YukkuriPannda/vibe_comp/kicad/bass_compressor/render/bass_compressor_render.png

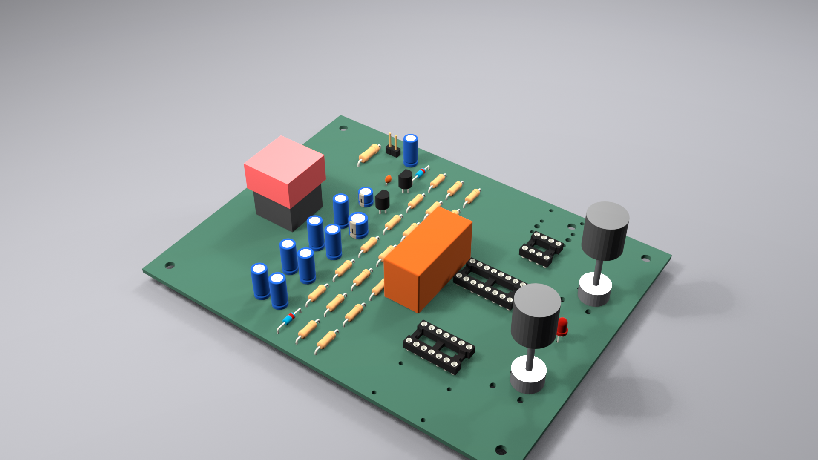
kicad/bass_compressor/render/bass_compressor_render.png
