YukkuriPannda/vibe_comp/docs/circuit_reference.md

# 回路設計（Phase 1 確定版 / 2026-07-01）

**重要**: この回路はデータシートの式・KiCad標準シンボルのピン配置と照合して設計したオリジナル設計であり、既存の特定ペダル(Ross Compressor等)のコピーではない。**まだSPICEシミュレーション(Phase2)・ブレッドボード試作(Phase3)による実機検証を行っていない。** 基板発注(Phase6)の前に必ずPhase2/3を実施すること。特にコンプレッサーは帰還の極性を間違えると圧縮ではなく発振・エキスパンダー的動作になるため、試作確認は必須。

## 使用ICのピン配置（データシート/KiCad標準シンボルで確認済み）

### LM13700（16pin DIP, デュアルOTA）— TIデータシート(SNOSBW2F)の "Pin Functions" 表で確認
| Pin | 機能 | Pin | 機能 |
|---|---|---|---|
| 1 | IABC1（ゲイン制御電流入力） | 9 | Buffer Output 2 |
| 2 | Diode Bias 1 | 10 | Buffer Input 2 |
| 3 | Non-inverting Input 1 (+) | 11 | V+ |
| 4 | Inverting Input 1 (−) | 12 | Output 2 |
| 5 | Output 1 | 13 | Inverting Input 2 (−) |
| 6 | V− | 14 | Non-inverting Input 2 (+) |
| 7 | Buffer Input 1 | 15 | Diode Bias 2 |
| 8 | Buffer Output 1 | 16 | IABC2 |

今回は**OTA#1（pin1-8）のみ使用**、OTA#2は未使用（後述の通り無効化）。

### TL072（8pin DIP, デュアルオペアンプ）— 標準ピン配置
1=Out1, 2=In1(−), 3=In1(+), 4=V−, 5=In2(+), 6=In2(−), 7=Out2, 8=V+

### TC4013BP（14pin DIP, デュアルDフリップフロップ）— 標準ピン配置
1=Q1, 2=/Q1, 3=CLK1, 4=RESET1, 5=D1, 6=SET1, 7=VSS(GND), 8=SET2, 9=D2, 10=RESET2, 11=CLK2, 12=/Q2, 13=Q2, 14=VDD

今回は**フリップフロップ#1のみ使用**（トグル動作: /Q1をD1に帰還）。

## 全体ブロック構成

```
入力Jack(J1,電池ON/OFF兼用)
  → 入力バッファ(U1A)
  → OTAゲイン制御段(IC1 LM13700 OTA#1、Sustainで帰還量を調整)
  → メイクアップゲイン段(U1B)
  → Levelポット(VR2)
  → 出力Jack(J2)

OTA出力ノード → エンベロープ検出(D1,C_hold等) → Sustainポット(VR1) → Q_ctrl(NPN) → IABC1(帰還でゲイン低下=圧縮)

Cherry MXスイッチ(SW1、手持ち部品) → デバウンス → TC4013 Dフリップフロップ(トグル)
  → Q_relay(NPN)駆動 → リレー(RL1, DPDT) → 信号経路をトゥルーバイパス切替
  → LED1(フリップフロップの状態を表示)
```

## 1. 電源・バイアス

| 部品 | 値 | 備考 |
|---|---|---|
| BT1 | 9V電池 | J1のスイッチ接点経由でON/OFF |
| C_pwr1 | 100µF/16V 電解 | V+-GND間、電源デカップリング |
| C_pwr2 | 0.1µF セラミック | 同上、高周波用 |
| R1, R2 | 100kΩ ×2 | V+-GND分圧、中点=Vref(≈4.5V)。オペアンプ段のバイアス基準専用（LM13700本体のV−ピンは真のGND=0Vに接続、Vrefには繋がない） |
| C_vref | 10µF 電解 | Vrefノード-GND、バイアス安定化 |

## 2. 入力バッファ（U1A: TL072 1回路目）

| 部品 | 値 | 備考 |
|---|---|---|
| C_in | 0.1µF フィルム | 入力DCブロック |
| R_inbias | 1MΩ | C_in後段からVrefへ。入力インピーダンス≈1MΩ、C_inとのカットオフ≈1.6Hz（4弦ベース最低音41Hzを一切減衰させない） |
| U1A | TL072 pin3(+)=上記ノード, pin2(−)=pin1(出力)に直結（ボルテージフォロワ）, pin4=GND, pin8=V+ |

## 3. OTAゲイン制御段（IC1: LM13700 OTA#1）

**【2026-07-01 SPICE検証で追加修正】** LTspice + LM13700の実トランジスタレベルSPICEモデル(deanm1278/LM13700-spice-model, TIの公開回路を元にしたもの)で検証した結果、以下2点の設計不備が判明し修正した:

1. **入力にアッテネータが必要だった**: U1Aの出力(最大1.6Vpp程度を想定)をそのままOTAの差動入力に入れると、OTAの実用線形入力範囲(データシートFig.20の例で「1Vpの入力を33mVppまで減衰させる」と明記、リニアライズダイオード使用時でも60mVpp程度が上限)を100倍以上超えてしまい、圧縮が効く前にほぼ常時ハードクリップする計算になった。→ **U1A出力とOTA入力の間にアッテネータ(1/60程度)を追加**
2. **OTA差動入力のDCバイアス基準点が誤っていた**: 「pin3→GND直結」「pin4→GND直結」という当初設計は、SPICEモデル上で出力が全く出ない(ゲインほぼゼロ)結果になった。差動入力トランジスタがV−レール付近で電流不足になり事実上遮断されるため。→ **pin3・pin4とも基準をGNDではなくVref(4.5V、オペアンプ段と同じ仮想グラウンド)に変更**

これらはSPICEモデル特有の癖ではなく、実チップの差動入力段がV−レール際で正常動作しないという一般的なバイポーラ差動対の制約に起因すると考えられるため、実機でも同様の修正が必要と判断した。

| 部品 | 値 | 接続 | 備考 |
|---|---|---|---|
| R_atten_a | 100kΩ | U1A出力 → ATTMIDノード | 入力アッテネータ上側（Vref基準の減衰、結合コンデンサの**前**に置く。結合コンデンサの後に低い値の抵抗を置くとOTA入力のDCバイアスを壊すことがSPICE検証で判明したため） |
| R_atten_b | 1.6kΩ | ATTMIDノード → Vref | 入力アッテネータ下側。R_atten_a/(R_atten_a+R_atten_b)で約1/63.5に減衰 |
| C2 | 1µF | ATTMIDノード → pin3(Non-inv+) | ACカップリング |
| R3 | 100kΩ | pin3 → **Vref**（2026-07-01修正、旧GND） | 入力DCバイアス基準。GND直結だと出力ゲインがほぼゼロになることをSPICEで確認したため、オペアンプ段と同じVref基準に変更 |
| — | — | pin4(Inv−) → **Vref直結**（2026-07-01修正、旧GND直結） | シングルエンド駆動。理由はpin3と同じ |
| R_D | 7.5kΩ | V+(9V) → pin2(Diode Bias) | ID≈1mA、データシート推奨値でリニアライズ用ダイオード電流を設定（歪み低減。圧縮動作そのものには無関係の固定値） |
| R_ABC | **75kΩ**（2026-07-01再修正、820kΩ→75kΩ） | V+(9V) → pin1(IABC1) | 無音時のベースゲインを設定。IABC≈100µA。SPICEでIABCを20µA〜5mAまで振ったところ、500µA以上では電源電圧(9V)に対してOTA単体のゲインが飽和(クリップ)してしまい、100µA前後が「クリップせず、かつSPICEが素直に収束する」実用的なレンジと判明。OTA単体のゲインは控えめ(入力換算で1〜1.3倍程度)だが、後段の**メイクアップゲイン段(5.7倍)と合わせてトータルで妥当なレベルに戻す**設計とする |
| Q_ctrl | 2SC1815(またはNPN汎用) | コレクタ→pin1、エミッタ→GND、ベース←R_base(2.2kΩ)←VR1ワイパー | エンベロープ電圧に応じてIABCを引き下げ=ゲイン低下=圧縮 |
| RL | 47kΩ | pin5(Output1) → Vref | OTA出力(電流出力)を電圧に変換。gm=19.2×IABC[A] (データシート記載式)、電圧ゲイン=gm×RL |
| pin6(V−) | — | GND直結 | LM13700をV+=9V/V−=0Vのシングル電源で動作 |
| pin11(V+) | — | V+(9V)直結 | 両OTA共通 |
| pin16(IABC2) | — | GND直結 | OTA#2を完全オフ（未使用ユニットの標準処理） |
| pin13,14(OTA2入力) | — | GND直結 | 未使用ユニットのノイズ拾い防止 |
| pin15(Diode Bias2) | — | GND直結 | 同上 |
| pin7,10(Buffer Input 1,2) | — | GND直結 | 未使用バッファの標準処理（出力8,9はNC） |

## 4. エンベロープ検出（Sustain制御ループ）

OTA出力ノード(pin5/RLの接続点)からタップし、圧縮の判定に使う信号を作る。

| 部品 | 値 | 接続 |
|---|---|---|
| C_env | 0.1µF | pin5ノード → ノードA |
| R_envbias | 1MΩ | ノードA → GND（ノードAのDC基準を0Vに設定。AC信号のみ通す） |
| D1 | 1N4148 | アノード=ノードA、カソード→R_attack |
| R_attack | 2.2kΩ | D1カソード → C_hold（アタックタイム τ≈2.2ms） |
| C_hold | 1µF | R_attack後段 → GND（エンベロープ保持コンデンサ） |
| R_release | 220kΩ | C_holdと並列（リリースタイム τ≈220ms） |
| **R_prebias**（2026-07-01追加） | **3.3MΩ** | **V+(9V) → C_hold/R_release側のノード（R_releaseと並列）** | 無信号時のエンベロープノードを約0.56Vにプリバイアスする（下記Phase2検証参照）。R_releaseと並列合成されるため実効リリース抵抗は約206kΩ(τ≈206ms、大きくは変わらない) |
| VR1 (Sustainポット) | 10kΩ（秋月 `RK09D117000B` 等） | C_hold後段(R_prebiasでバイアスされたノード) → ワイパー → R_base(2.2kΩ) → Q_ctrlベース。**電圧分圧のスケーラーとして使用**（直列可変抵抗ではなく、検出電圧がQ_ctrlベースに伝わる比率を調整する構成。秋月で入手できる10kΩ単連ポットでも十分機能するよう設計） |

**Attack/Release値は固定**（前回の仕様確定どおり、ノブはSustain/Levelのみ）。Phase2/3で実際に鳴らしながら微調整可能なようR_attack/R_releaseは基板上でランド互換の値違い品に差し替え可能な配置にしておくと良い。

## Phase 2: 手計算による検証と発見されたバグ（2026-07-01）

SPICEシミュレータ(ngspice/LTspice)がこの環境で即座に使える状態になかったため、データシートの式(gm≈19.2×IABC[A]、VBIAS=2VBE+V−等)を使った手計算での検証を実施。**この過程で実機が正しく動作しない可能性が高い設計バグを2つ発見し、修正した。**

### バグ1: OTA段の無音時ゲインが過大（RL=47kΩ, 旧R_ABC=33kΩ）
- 旧設計: IABC≈233µA → gm=19.2×233µA≈4.48mA/V → 電圧ゲイン=gm×RL=4.48m×47k≈**210倍(46dB)**
- ベース信号(passive想定で0.1〜0.5Vpk程度)を210倍すると21〜105Vppに相当し、9V単電源(Vref=4.5V中心)では物理的に出力し切れず、**圧縮が効く前にほぼ常時ハードクリップする**状態だった
- **対策**: R_ABCを33kΩ→**820kΩ**に変更。IABC≈9.3µA→gm≈179µS→無音時ゲイン≈**8.4倍(18.5dB)**に抑制。0.5Vpk入力でも4.2Vpk程度に収まり、9V電源内で現実的なヘッドルームに収まる

### バグ2: エンベロープ検出電圧がQ_ctrlのベースを駆動できない
- 旧設計: エンベロープノードは無信号時0V基準で、信号が来た時だけD1(1N4148, 順方向降下≈0.6V)経由でC_holdを充電する構成だった。ベース信号は控えめなレベルのことが多く、整流後の電圧(1Vpk入力でも≈0.4V程度)ではQ_ctrl(2SC1815, Vbe(on)≈0.6V)がほとんどオンにならず、**現実的な入力レベルでは圧縮がほぼかからない**可能性が高かった
- **対策**: R_prebias(3.3MΩ, V+→エンベロープノード)を追加し、無信号時のエンベロープノードを約0.56V（Q_ctrlのオン閾値のすぐ下）にプリバイアス。VR1(Sustain)が0の時は結合が切れゲイン変化なし、VR1を上げるほどこのプリバイアス電圧がQ_ctrlベースに伝わり、そこに信号由来の追加電圧が上乗せされることで、小さな信号変化にも敏感に反応するようになる

### 検証はしたが未解決・Phase3実機調整が必要な項目
- [ ] OTA無音時ゲイン8.4倍は概算目標値であり、実際のベース(パッシブ/アクティブ、指弾き/スラップ等)の出力レベルに応じてR_ABC・RLを微調整する必要がある可能性が高い
- [ ] Q_ctrlのVbe(on)や2SC1815の個体差により、R_prebiasの3.3MΩは±20%程度ずれる可能性がある。ブレッドボードでテスターを当てながら微調整すること

## Phase 2b: 実SPICEシミュレーション（LTspice）での検証（2026-07-01）

上記の手計算に続き、実際にLTspiceをインストールし(`winget install AnalogDevices.LTspice`)、LM13700の実トランジスタレベルSPICEモデル（[deanm1278/LM13700-spice-model](https://github.com/deanm1278/LM13700-spice-model)、TIの公開回路がベース）を使って`sim/`ディレクトリでトランジェント解析を行った。

### この検証で追加で見つかり、上記セクション3に反映した設計修正
1. **OTA差動入力へのアッテネータ追加**（1/63.5、R_atten_a/R_atten_b新設）— 手計算では見落としていた、データシート自身が明記する「OTA入力は数十mVppまでしか線形動作しない」という制約に、そのままでは1.6Vpp近い信号を突っ込んでいたことが判明
2. **OTA差動入力(pin3, pin4)の基準をGNDからVrefに変更** — GND直結だとSPICE上でゲインがほぼゼロになることを確認。V−レール際で差動入力トランジスタが実質遮断される
3. **R_ABCを75kΩに再修正**（IABC≈100µA） — SPICEでIABCを20µA〜5mAまで振ったところ、47kΩの負荷抵抗・9V電源の条件では500µA以上でOTA単体のゲインが電源電圧に張り付いて飽和することが分かり、飽和しない範囲に再設定。その分ゲインが控えめになるため、メイクアップゲイン段(5.7倍)と合わせてトータルで帳尻を合わせる設計とした

### 検証の限界（正直に記載）
- 上記1〜3の修正を反映した回路全体でのトランジェント解析（実際に「静かな信号→大きな信号→静かに戻る」を流して波形上で圧縮を確認する）は、**このSPICEモデル特有の収束の癖により最終確認できていない**。具体的には、OTA入力をコンデンサでACカップリングした状態（＝実機と同じ、必須の構成）にすると、SPICEのソルバー（Newton法・Gminステッピング）が物理的に妥当でないと思われる別解に収束してしまう現象が再現性をもって発生し、初期条件の指定(`.ic`/`uic`)やバイアス抵抗値の調整でも解消できなかった
- 一方、OTA単体を理想電圧源で直接駆動した簡易テスト（`sim/isolate_test9.cir`等）では上記の修正方針（Vrefバイアス、適切なIABC範囲）で正常にゲインが出ることを確認済み。**上記1〜3の設計修正自体はデータシートの記述および単体テストの両方と整合しており、妥当性は高いと考えている**
- 結論: **今回のSPICE検証は「新たな2つの設計不備を発見・修正する」という実質的な成果を上げたが、修正後の全体波形での動作確認は未完了。** 最終的な動作確認はPhase3のブレッドボード実測に委ねる
- 関連ファイル: `sim/bass_compressor_test2.cir`（本回路のSPICEネットリスト）、`sim/isolate_test*.cir`（切り分け用の単体テスト群）、`sim/lm13700.sub`（使用したLM13700モデル）

## 5. メイクアップゲイン段（U1B: TL072 2回路目）

| 部品 | 値 | 接続 |
|---|---|---|
| C3 | 1µF | pin5(OTA出力)ノード → U1B pin5(+) |
| R5 | 100kΩ | U1B pin5(+) → Vref |
| R6 | 10kΩ | U1B pin6(−) → GND |
| R7 | 47kΩ | U1B pin6(−) → U1B pin7(出力)（帰還） |
| ゲイン | 1+47k/10k ≈ 5.7倍（≈15dB） | OTA段で失われるレベルを回復 |
| C4 | 1µF | U1B出力 → VR2(Level)へDCブロック |

## 6. 出力段

| 部品 | 値 | 備考 |
|---|---|---|
| VR2 (Levelポット) | 10kΩ Aカーブ（秋月`RK09D117000C`） | C4後段-GND間、ワイパーが出力 |
| C5 | 1µF | VR2ワイパー → J2(出力Jack)、DCブロック |
| J2 | 6.3mm標準ジャック（スイッチなし） | 出力専用 |

出力バッファは設けない（後段の入力インピーダンスが十分高いことを前提とした一般的なパッシブ出力段。TL072は2回路とも上記で使い切っているため追加不可）。

## 7. バイパス回路（Cherry MX + TC4013 + リレー = ソフトタッチ・トゥルーバイパス）

| 部品 | 値 | 接続 |
|---|---|---|
| SW1 | Cherry MX（手持ち） | 一端→GND、他端→ノードB |
| R_pu | 100kΩ | V+ → ノードB（プルアップ） |
| C_db | 0.1µF | ノードB → GND（デバウンス） |
| IC3 (TC4013BP) #1 | — | pin3(CLK1)←ノードB, pin5(D1)←pin2(/Q1)帰還でトグル動作, pin4(RESET1)→GND, pin6(SET1)→GND, pin7(VSS)→GND, pin14(VDD)→V+ |
| R_drive | 10kΩ | pin1(Q1) → Q_relayベース |
| Q_relay | 2SC1815(またはNPN汎用) | ベース←R_drive、コレクタ→リレーコイル(−)、エミッタ→GND |
| D2 (フライバック) | 1N4148 | リレーコイルと並列（カソード→V+側、アノード→コレクタ側）。コイルのスイッチオフ時の逆起電力からQ_relayを保護 |
| **R_coildrop** | **150Ω 1/2W** | **V+(9V) → リレーコイル(+)**。RL1(941H-2C-5D)はコイル定格5V/167Ω/29.9mAだが電源が9Vのため、150Ωを直列に入れてコイル電圧を約4.7Vに制限（データシート実測: 感動電圧4V以上を満たしつつ定格5Vを超えないよう調整） |
| RL1 | 941H-2C-5D（5V DPDT, 秋月） | **【2026-07-01修正】DPDTの2系統とも使い、正しいトゥルーバイパスにする（下記参照）** |
| LED1 + R_led | LED + 2.2kΩ | pin1(Q1) → R_led → LED1アノード、カソード→GND。フリップフロップの状態を直接表示 |

### RL1（DPDT）の正しい配線（修正版）

前バージョンでは「1系統のみ使用、もう1系統は予備」としていたが、これだと未使用側（コンプレッサー回路の出力）が常時出力ジャックに繋がったままになり、バイパス時もコンプレッサー側の出力段が信号経路に乗り続けてしまう（＝本当のトゥルーバイパスになっていない）。DPDTの2系統を両方使い、入力側・出力側を同時に切り替える構成に修正する。

- **Pole 1（入力切替）**: COM=入力信号(J1後段) / NO=C_in（コンプレッサー回路へ） / NC=ノードDRY（バイパス時の直通経路）
- **Pole 2（出力切替）**: COM=出力信号(J2へ) / NO=C5後段（コンプレッサー回路の出力） / NC=ノードDRY（Pole1のNCと同じノード）
- リレー非励磁（バイパス時）: 入力→NC→ノードDRY→NC→出力 の直通経路のみが繋がり、コンプレッサー回路は入力・出力とも完全に切り離される（正しいトゥルーバイパス）
- リレー励磁（エフェクトON時）: 入力→NO→コンプレッサー回路→C5→NO→出力 の経路のみが繋がる

## 8. 未確定・Phase2/3で検証が必要な項目

- [ ] Sustainポットの電圧分圧方式が実際に十分な圧縮レンジを生むか（シミュレーションで確認、R_attack/R_release/R_ABC/RLの微調整が必要になる可能性が高い）
- [ ] R_D(7.5kΩ)によるダイオードバイアス電流とTHDの実測確認
- [ ] リレー用150Ω 1/2W抵抗の発熱・動作電圧マージンの実機確認
- [ ] TC4013のCMOS出力(9V駆動)がLED(2.2kΩ)を直接安定駆動できるか実機確認（理論上は動くが規格上限に近い可能性）
- [ ] IC1(LM13700)は未使用側OTA(pin9-16の一部)も含めて実装時の消費電流を確認（電池駆動のため）
