YukkuriPannda/vibe_comp/bom/部品リスト.md

# 部品リスト（Digikey / Amazon 購入リンク付き）

KiCad回路図から出力したBOM（`kicad/bass_compressor/bom_kicad.csv`）を元に、リファレンス単位ではなく**部品の種類・定数ごとにまとめて集計**したもの。リンクは実在するページを検索・確認済み（2026-07-01〜07-02時点）。価格・在庫はDigikey/Amazon側で変動するため発注直前に必ず確認すること。

**購入リンク・型番・単価の一覧はExcelファイル [`部品リスト.xlsx`](./部品リスト.xlsx) にまとめてある（Digikey/Amazonへのハイパーリンク付き）。このMarkdownファイルは概要・注意点・見積もりのサマリーのみ。**

Cherry MXキースイッチ（SW1）は支給品（手持ち）のため購入対象から除外。

## 部品カテゴリ概要

| カテゴリ | 内容 | 詳細 |
|---|---|---|
| IC/半導体 | IC1 NJM13700D、IC3 TC4013BP(N,F)、U1 TL072CP、D1/D2 1N4148、Q1/Q2 2SC1815 | xlsx参照 |
| リレー・ジャック | RL1 941H-2C-5D、J1（代替品）、J2 Neutrik NMJ4HCD2 | xlsx参照。J1は要注意（後述） |
| ポット | VR1 Alps RK09K1130D62（10kΩB）、VR2 Alps RK09D117000C（10kΩA） | xlsx参照。VR2は要確認（後述） |
| 抵抗 | 10種・21本 | xlsx参照（検索リンク） |
| コンデンサ | 5種・11個 | xlsx参照（検索リンク、サイズ注意） |
| その他一般部品 | LED、9V電池スナップ、ICソケット×3、ピンヘッダ | xlsx参照（検索リンク） |

## 2026-07-02更新：IC1・J1の代替手段

### IC1（OTA）— Digikeyでは全世代が廃盤。Amazon一択
LM13700N/NOPB、NJM13700D、NJM13600D、**NE5517N**（LM13700Nのセカンドソース品として知られる代替候補）の4つをDigikeyで個別に確認したが、**すべて「Obsolete（廃盤・製造終了）」表示で価格非掲載**だった。この世代の古典的なDIP-16デュアルOTAはDigikeyでは実質調達不可という結論。
→ 現状唯一の現実的な調達先は**Amazon.co.jp（NJM13700D 5個ロット 約¥1,025）**。コンプレッサー回路の心臓部なのでリマーク品リスクに注意し、予備を含め確保すること。

### J1（入力ジャック）— Neutrik NRJ6HFからCUI/Same Sky SJ-63053Aに代替
元指定のNeutrik NRJ6HFはDigikeyでMOQ50個のマーケットプレイス出品しかなく、型番通り買うとジャック1個のために約$232（≒¥35,000）かかってしまう。
→ **CUI（Same Sky）SJ-63053A**（6.35mm TRS・3極・水平PCB取付・スイッチなし）に代替。Digikeyで実在庫578個・単品購入可（単価$3.05≒¥458）。この部品自体も廃盤表示だが在庫販売中で、単品購入が可能な点がNRJ6HFと決定的に違う。
- 電気的な適合性：J1は回路上「TRS(mono use)」として使われており、リング端子は音声信号ではなくバッテリーON/OFFスイッチ用（モノラルプラグを挿すとリングがスリーブに接触して電源が入る設計）。この機構はジャック自体に専用スイッチ接点を必要とせず、単純な3極(Tip/Ring/Sleeve)ジャックであれば動作するため、スイッチなしのSJ-63053Aで機能上の問題はない。
- 物理的な適合性：フットプリント（Neutrik NRJ6HF用の足配置）とSJ-63053Aのピン配置は完全一致するとは限らないため、**基板発注済みの場合は先に現物のピン配置を照合すること**（未発注ならフットプリントをSJ-63053A用に差し替えるのが確実）。

## 互換性確認結果（2026-07-02）

| 部品 | 判定 | 内容 |
|---|---|---|
| IC1 NJM13700D | 適合（部品自体） | DIP-16・7.62mmピッチでfootprint/ピン配置と一致。ただし調達はAmazon一択（上記） |
| IC3 TC4013BP(N,F) | 適合 | DIP-14・7.62mmピッチで一致 |
| U1 TL072CP | 適合 | DIP-8・7.62mmピッチで一致 |
| Q1, Q2 2SC1815 | 適合 | TO-92で一致 |
| RL1 941H-2C-5D | **要注意** | メーカー公式寸法とfootprint「Relay_DPDT_Schrack-RT2-FormC_RM5mm」の間に約0.1mm前後のピン間隔差異あり。基板発注前に現物かデータシート図面で要再確認 |
| J1（SJ-63053Aに代替） | **要確認** | 機能面は適合（上記）。物理フットプリントは未照合、発注前に要確認 |
| J2 NMJ4HCD2 | 適合 | パッケージ・水平取付・スイッチ未使用の仕様とも回路図Notesの設計意図と一致 |
| VR1 RK09K1130D62 | 適合 | Alps公式カタログで単連・垂直取付・10kΩ・Bカーブと確認、footprintと完全一致 |
| VR2 RK09D117000C | **要注意** | 10kΩ・Aカーブ(Log)は確認済みだが、垂直取付であることの一次資料なし。RK09Dシリーズは同型番体系内に垂直/水平が混在するため発注前に要確認 |
| コンデンサ (C2-C5, C8-C11) | 要注意 | footprintが直径5.0mm・高さ11.0mm・リードピッチ2.00mm指定。汎用フィルムコンデンサはピッチ5mm/7.5mm/10mm品も多く流通しているため、購入時はこのサイズに収まる製品を選ぶこと |

## 見積もり再試算（2026-07-02、送料別・1ドル=150円換算）

J1をSJ-63053Aに代替した上での再計算。

| 区分 | 内容 | 小計 |
|---|---|---:|
| Digikeyで揃う分 | IC3(¥260) + U1(¥176) + D1,D2(¥30) + Q1,Q2(¥532) + J1代替品(¥458) + J2(¥380) + VR1(¥338) + VR2(¥323) + 抵抗21本(¥315) + コンデンサ11個(¥456) + その他汎用品(¥346) | **約¥3,610** |
| Amazon必須分 | IC1 NJM13700D 5個ロット(¥1,025) + RL1(¥550) | **約¥1,575** |
| **総合計（送料別、2口発注）** | | **約¥5,190** |

旧・秋月電子ルートの見積もり（約¥4,000〜5,000）とほぼ同水準に収まる。J1を型番（NRJ6HF）に固執した場合は総額が約¥39,500まで跳ね上がるため、**J1の代替は費用面でも必須の対応**。

## 調達方針まとめ

- **IC1（OTA）**：Digikeyでは古典的DIP-16デュアルOTA全世代が廃盤のため、**Amazon.co.jp一択**（NJM13700D 5個ロット）。予備を確保し、リマーク品リスクに注意。
- **J1（入力ジャック）**：Neutrik NRJ6HF指定のままだとDigikeyでMOQ50個・約¥35,000かかるため、**CUI/Same Sky SJ-63053A**（Digikey・単品購入可・約¥458）に代替。発注前に基板フットプリントとの現物照合が必要。
- **J2（出力ジャック）**：Neutrik NMJ4HCD2のままでDigikeyから単品購入可。
- **RL1（リレー）**：DigikeyにもMouserにも取扱なし。Amazon.co.jpか秋月電子（`akizukidenshi.com/catalog/g/g101229/`）から調達。ピン間隔は基板発注前に現物確認必須。
- **VR2ポット**：垂直取付であることの確証がないため、発注前に現物かAlps正式図面で要確認。
- **その他IC・トランジスタ・VR1**：Digikey・Amazonどちらでも調達可能。
- 抵抗・コンデンサ・LED・ICソケット・ピンヘッダ・電池スナップは値さえ合えば汎用品で問題ないため、xlsxの検索リンクから在庫のあるものを選定すること（コンデンサはサイズ・ピッチに注意）。
