YukkuriPannda/vibe_comp/bom/部品リスト.xlsx

カテゴリ | リファレンス | 部品説明 | 数量 | Digikey型番 | Digikeyリンク | Digikey単価(円) | Digikey備考 | Amazonリンク | Amazon価格(円) | Amazon備考
IC | IC1 | NJM13700D (デュアルOTA DIP-16、LM13700N互換) | 1 | NJM13700D | https://www.digikey.com/en/products/detail/njr-corporation-njrc/NJM13700D/805535 |  | Obsolete(廃盤・購入不可)。LM13700N/NJM13600D/NE5517NもDigikeyで全て廃盤確認済み | https://www.amazon.co.jp/5%E5%80%8B-%E3%83%AD%E3%83%83%E3%83%88-13700D-NJM13700D-NJM13700/dp/B0CZPDBSWG | 1025 | 5個ロット(実質1個約205円)。Digikey不可のため唯一の調達ルート
IC | IC3 | TC4013BP(N,F) (Dフリップフロップx2 DIP-14) | 1 | TC4013BP(N,F) | https://www.digikey.jp/ja/products/detail/toshiba-semiconductor-and-storage/TC4013BP-N-F/6154565 | 260 | 在庫あり | https://www.amazon.co.jp/TOSHIBA-TC4013BP-N-F-10%E5%80%8B%E3%82%BB%E3%83%83%E3%83%88/dp/B01ARN700C | 1750 | 10個セット(実質1個約175円)
IC | U1 | TL072CP (デュアルオペアンプ DIP-8) | 1 | TL072CP | https://www.digikey.com/en/products/detail/texas-instruments/TL072CP/277421 | 176 | 在庫あり | https://www.amazon.co.jp/eMagTech-%E3%83%87%E3%83%A5%E3%82%A2%E3%83%AB%E4%BD%8E%E3%83%8E%E3%82%A4%E3%82%BATL072CP-DIP-8%E3%82%AA%E3%83%9A%E3%82%A2%E3%83%B3%E3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 | 1000 | 10個入(実質1個約100円)
半導体 | D1, D2 | 1N4148 (整流ダイオード) | 2 | 1N4148 | https://www.digikey.com/en/products/detail/onsemi/1N4148/458603 | 15 | 単価目安 | https://www.amazon.co.jp/s?k=1N4148+%E3%83%80%E3%82%A4%E3%82%AA%E3%83%BC%E3%83%89 |  | 検索リンク(汎用品)
半導体 | Q1, Q2 | 2SC1815 (バイパス駆動Tr TO-92、Central Semiconductor品) | 2 | 2SC1815-PBFREE | https://www.digikey.jp/ja/products/detail/central-semiconductor-corp/2SC1815-PBFREE/5777301 | 266 | 在庫あり | https://www.amazon.co.jp/20PCS-2SC1815GR-2SC1815-%E3%83%88%E3%83%A9%E3%83%B3%E3%82%B8%E3%82%B9%E3%82%BF-Marking/dp/B07R4G2WWW | 599 | 20個入(実質1個約30円)
リレー・ジャック | RL1 | 941H-2C-5D (5V DPDTリレー) | 1 |  |  |  | Digikey/Mouserとも取扱なし | https://www.amazon.co.jp/HSIN-PRECISION-941H-2C5D-5V%E5%B0%8F%E5%9E%8B%E3%83%AA%E3%83%AC%E3%83%BC-%E6%8E%A5%E7%82%B9%E5%AE%B9%E9%87%8F2%EF%BC%A1-2%E5%9B%9E%E8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 | 550 | 現物でピン間隔をfootprintと要照合
リレー・ジャック | J1 | CUI/Same Sky SJ-63053A (6.35mm TRS 3極 水平PCB取付 スイッチなし。元指定Neutrik NRJ6HFの代替) | 1 | SJ-63053A | https://www.digikey.com/en/products/detail/cui-devices/SJ-63053A/13155730 | 458 | 廃盤品だが実在庫578個・単品購入可(単価$3.05)。元のNRJ6HFはDigikeyがMOQ50個のマーケットプレイス品のみで1個購入不可のため代替 |  |  | Amazon同等品なし(本文参照)
リレー・ジャック | J2 | Neutrik NMJ4HCD2 (6.35mm TS スイッチ付 水平PCB取付) | 1 | NMJ4HCD2 | https://www.digikey.com/en/products/detail/neutrik-americas-inc/NMJ4HCD2/29371256 | 380 | 単品購入可・在庫あり |  |  | Amazon同一型番なし
ポット | VR1 | Alps RK09K1130D62 (10kΩ Bカーブ 垂直単連 Sustain用) | 1 | RK09K1130D62 | https://www.digikey.com/en/products/detail/alps-alpine/RK09K1130D62/21721547 | 338 | footprintと適合確認済み | https://www.amazon.co.jp/Alps-Electric-%E3%83%9D%E3%83%86%E3%83%B3%E3%82%B7%E3%83%A7%E3%83%A1%E3%83%BC%E3%82%BF-0-05W-RK09D1130C2P/dp/B091B4K8G2 | 439 | 型番はRK09D1130C2P(同等の10kΩ)
ポット | VR2 | Alps RK09D117000C (10kΩ Aカーブ Level用) | 1 | RK09D117000C | https://www.digikey.com/en/products/detail/alps-alpine/RK09D117000C/21721659 | 323 | 垂直取付の一次資料なし・要現物確認 | https://www.amazon.co.jp/s |  | 検索リンク
抵抗 | R1,R2,R3,R5,R15,R20 | 100kΩ 1/4W | 6 |  | https://www.digikey.com/en/products/result?keywords=100k+ohm+1%2F4W+resistor |  | 検索リンク | https://www.amazon.co.jp/s?k=%E6%8A%B5%E6%8A%97+100k%CE%A9+1%2F4W |  | 検索リンク
抵抗 | R4,R7 | 47kΩ 1/4W | 2 |  | https://www.digikey.com/en/products/result?keywords=47k+ohm+1%2F4W+resistor |  | 検索リンク | https://www.amazon.co.jp/s?k=%E6%8A%B5%E6%8A%97+47k%CE%A9+1%2F4W |  | 検索リンク
抵抗 | R6,R17 | 10kΩ 1/4W | 2 |  | https://www.digikey.com/en/products/result?keywords=10k+ohm+1%2F4W+resistor |  | 検索リンク | https://www.amazon.co.jp/s?k=%E6%8A%B5%E6%8A%97+10k%CE%A9+1%2F4W |  | 検索リンク
抵抗 | R8 | 7.5kΩ 1/4W | 1 |  | https://www.digikey.com/en/products/result?keywords=7.5k+ohm+1%2F4W+resistor |  | 検索リンク | https://www.amazon.co.jp/s?k=%E6%8A%B5%E6%8A%97+7.5k%CE%A9+1%2F4W |  | 検索リンク
抵抗 | R9 | 75kΩ 1/4W | 1 |  | https://www.digikey.com/en/products/result?keywords=75k+ohm+1%2F4W+resistor |  | 検索リンク | https://www.amazon.co.jp/s?k=%E6%8A%B5%E6%8A%97+75k%CE%A9+1%2F4W |  | 検索リンク
抵抗 | R10,R12,R18 | 2.2kΩ 1/4W | 3 |  | https://www.digikey.com/en/products/result?keywords=2.2k+ohm+1%2F4W+resistor |  | 検索リンク | https://www.amazon.co.jp/s?k=%E6%8A%B5%E6%8A%97+2.2k%CE%A9+1%2F4W |  | 検索リンク
抵抗 | R11,R14 | 1MΩ 1/4W | 2 |  | https://www.digikey.com/en/products/result?keywords=1M+ohm+1%2F4W+resistor |  | 検索リンク | https://www.amazon.co.jp/s?k=%E6%8A%B5%E6%8A%97+1M%CE%A9+1%2F4W |  | 検索リンク
抵抗 | R13 | 220kΩ 1/4W | 1 |  | https://www.digikey.com/en/products/result?keywords=220k+ohm+1%2F4W+resistor |  | 検索リンク | https://www.amazon.co.jp/s?k=%E6%8A%B5%E6%8A%97+220k%CE%A9+1%2F4W |  | 検索リンク
抵抗 | R16 | 150Ω 1/2W | 1 |  | https://www.digikey.com/en/products/result?keywords=150+ohm+1%2F2W+resistor |  | 検索リンク | https://www.amazon.co.jp/s?k=%E6%8A%B5%E6%8A%97+150%CE%A9+1%2F2W |  | 検索リンク
抵抗 | R19 | 3.3MΩ 1/4W | 1 |  | https://www.digikey.com/en/products/result?keywords=3.3M+ohm+1%2F4W+resistor |  | 検索リンク | https://www.amazon.co.jp/s?k=%E6%8A%B5%E6%8A%97+3.3M%CE%A9+1%2F4W |  | 検索リンク
抵抗 | R21 | 1.6kΩ 1/4W | 1 |  | https://www.digikey.com/en/products/result?keywords=1.6k+ohm+1%2F4W+resistor |  | 検索リンク | https://www.amazon.co.jp/s?k=%E6%8A%B5%E6%8A%97+1.6k%CE%A9+1%2F4W |  | 検索リンク
コンデンサ | C2,C3,C4,C5,C10 | 1uF フィルム(ラジアル D5.0mm H11.0mm P2.00mm) | 5 |  | https://www.digikey.com/en/products/result?keywords=1uF+film+capacitor+radial |  | 検索リンク(サイズ要確認) | https://www.amazon.co.jp/s |  | 検索リンク(サイズ要確認)
コンデンサ | C8,C9,C11 | 0.1uF フィルム(ラジアル D5.0mm H11.0mm P2.00mm) | 3 |  | https://www.digikey.com/en/products/result?keywords=0.1uF+film+capacitor+radial |  | 検索リンク(サイズ要確認) | https://www.amazon.co.jp/s |  | 検索リンク(サイズ要確認)
コンデンサ | C6 | 0.1uF セラミックディスク | 1 |  | https://www.digikey.com/en/products/result?keywords=0.1uF+ceramic+disc+capacitor |  | 検索リンク | https://www.amazon.co.jp/s |  | 検索リンク
コンデンサ | C1 | 100uF/16V 電解 | 1 |  | https://www.digikey.com/en/products/result?keywords=100uF+16V+electrolytic+capacitor+radial |  | 検索リンク | https://www.amazon.co.jp/s |  | 検索リンク
コンデンサ | C7 | 10uF 電解 | 1 |  | https://www.digikey.com/en/products/result?keywords=10uF+electrolytic+capacitor+radial |  | 検索リンク | https://www.amazon.co.jp/s?k=%E9%9B%BB%E8%A7%A3%E3%82%B3%E3%83%B3%E3%83%87%E3%83%B3%E3%82%B5+10uF |  | 検索リンク
その他 | LED1 | 3mm LED | 1 |  | https://www.digikey.com/en/products/result?keywords=3mm+LED |  | 検索リンク | https://www.amazon.co.jp/s?k=LED+3mm |  | 検索リンク
その他 | BT1(電池スナップ) | 9V電池スナップ | 1 |  | https://www.digikey.com/en/products/result?keywords=9V+battery+snap+connector |  | 検索リンク | https://www.amazon.co.jp/9V%E3%83%90%E3%83%83%E3%83%86%E3%83%AA%E3%83%BC%E3%82%B9%E3%83%8A%E3%83%83%E3%83%97-9V%E9%9B%BB%E6%B1%A0%E3%82%B9%E3%83%8A%E3%83%83%E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 | 222 | 2個セット約445円
その他 | ICソケット(IC1用) | DIP-16 ICソケット | 1 |  | https://www.digikey.com/en/products/result?keywords=DIP-16+IC+socket |  | 検索リンク | https://www.amazon.co.jp/s?k=DIP16+IC%E3%82%BD%E3%82%B1%E3%83%83%E3%83%88 |  | 検索リンク
その他 | ICソケット(IC3用) | DIP-14 ICソケット | 1 |  | https://www.digikey.com/en/products/result?keywords=DIP-14+IC+socket |  | 検索リンク | https://www.amazon.co.jp/s?k=DIP14+IC%E3%82%BD%E3%82%B1%E3%83%83%E3%83%88 |  | 検索リンク
その他 | ICソケット(U1用) | DIP-8 ICソケット | 1 |  | https://www.digikey.com/en/products/result?keywords=DIP-8+IC+socket |  | 検索リンク | https://www.amazon.co.jp/s?k=DIP8+IC%E3%82%BD%E3%82%B1%E3%83%83%E3%83%88 |  | 検索リンク
その他 | ピンヘッダ(BT1用) | 2.54mmピッチ 1x2 ピンヘッダ | 1 |  | https://www.digikey.com/en/products/result?keywords=2.54mm+pin+header+1x2 |  | 検索リンク | https://www.amazon.co.jp/s?k=%E3%83%94%E3%83%B3%E3%83%98%E3%83%83%E3%83%80+2.54mm+2P |  | 検索リンク
