YukkuriPannda/vibe_comp/kicad/bass_compressor/3dmodels/DIP-14_W7.62mm_Socket.step

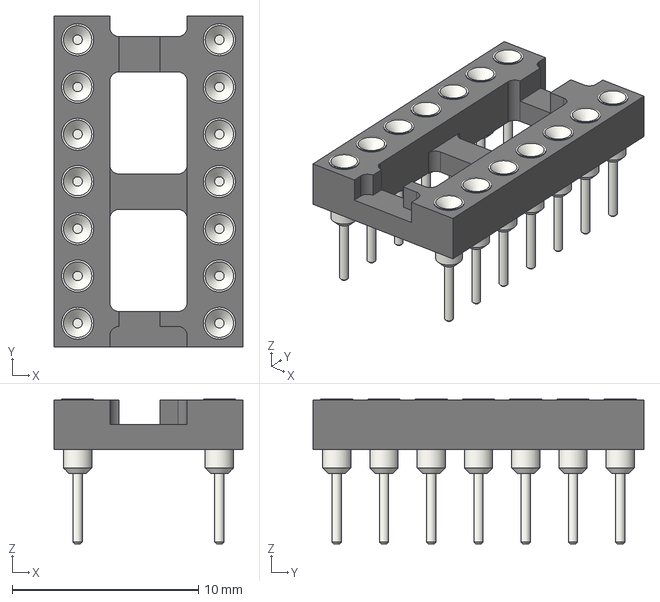
[picture p3: CAD file, 2026-07-02]
kicad/bass_compressor/3dmodels/DIP-14_W7.62mm_Socket.step
10.2 x 17.8 x 7.79 mm
