YukkuriPannda/vibe_comp/kicad/bass_compressor/3dmodels/NEUTRIK_NRJ6HF.stp

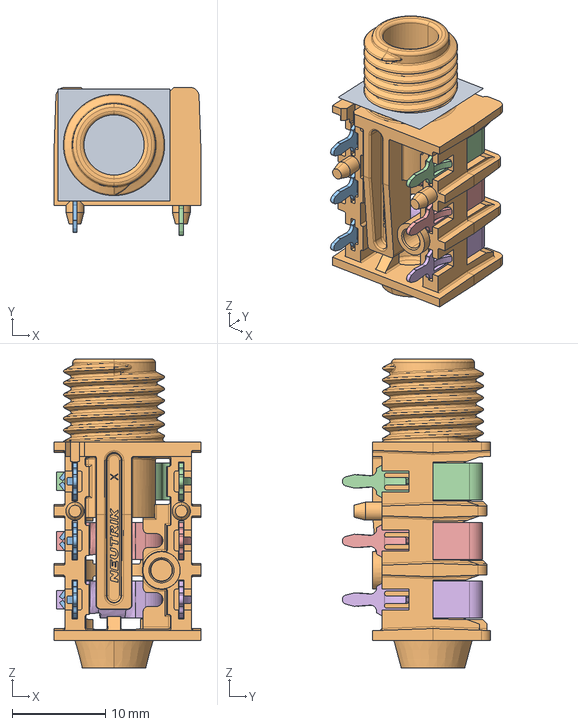
[picture p5: CAD file, 2026-07-02]
kicad/bass_compressor/3dmodels/NEUTRIK_NRJ6HF.stp
15.8 x 16.0 x 33.2 mm
