YukkuriPannda/vibe_comp/kicad/bass_compressor/3dmodels/Relay_DPDT_Schrack-RT2-FormC_RM5mm.step

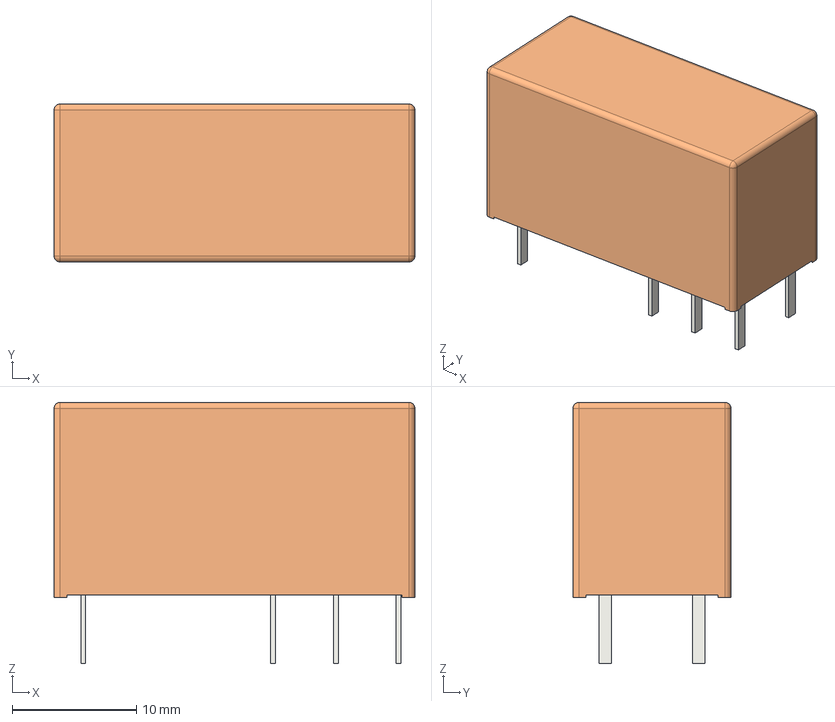
[picture p7: CAD file, 2026-07-02]
kicad/bass_compressor/3dmodels/Relay_DPDT_Schrack-RT2-FormC_RM5mm.step
29.0 x 12.7 x 21.0 mm
