YukkuriPannda/vibe_comp/kicad/bass_compressor/3dmodels/ALPS-RK09K.step

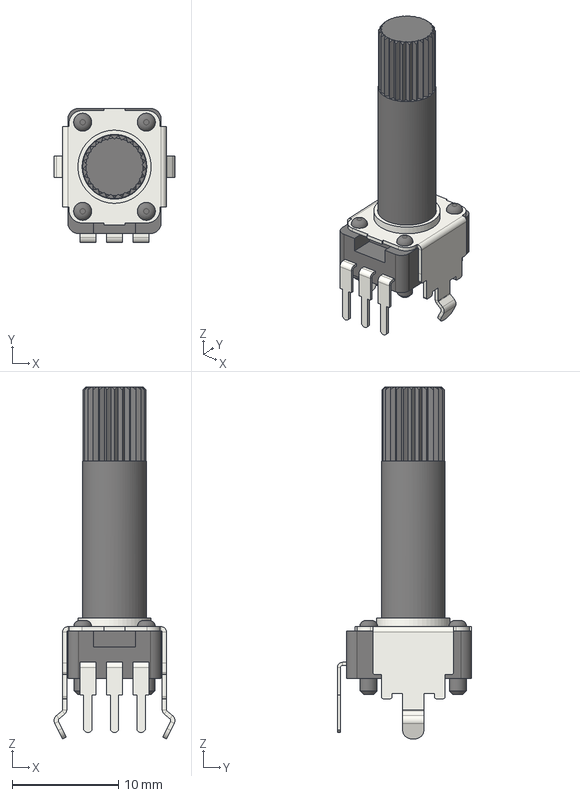
[picture p8: CAD file, 2026-07-02]
kicad/bass_compressor/3dmodels/ALPS-RK09K.step
11.4 x 12.7 x 33.2 mm
