YukkuriPannda/vibe_comp/kicad/bass_compressor/3dmodels/NEUTRIK_NMJ4HCD2.stp

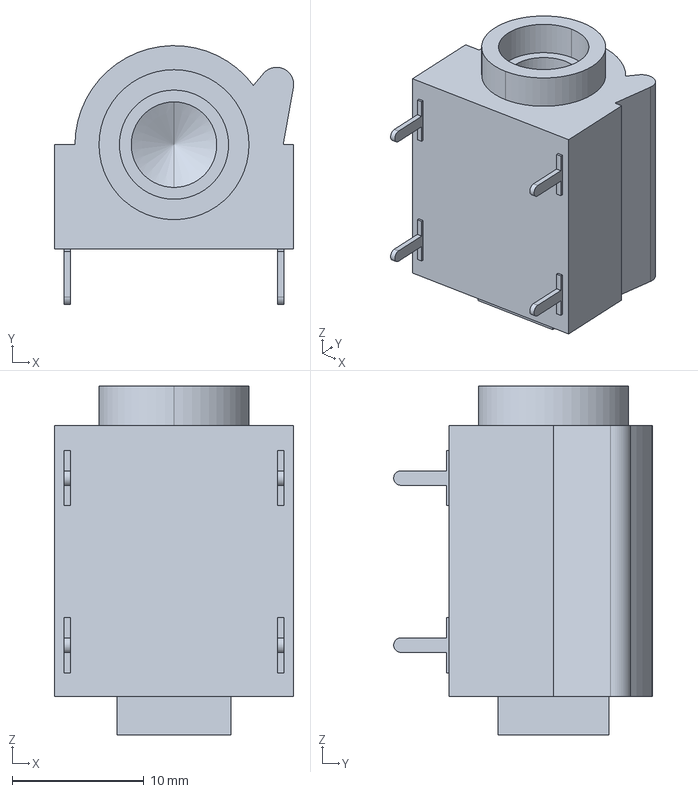
[picture p9: CAD file, 2026-07-02]
kicad/bass_compressor/3dmodels/NEUTRIK_NMJ4HCD2.stp
18.2 x 19.7 x 26.5 mm
