YukkuriPannda/vibe_comp/kicad/bass_compressor/3dmodels/TO-92.step

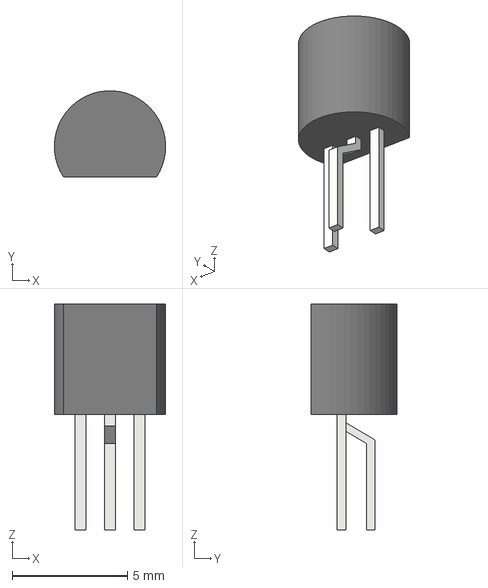
[picture p10: CAD file, 2026-07-02]
kicad/bass_compressor/3dmodels/TO-92.step
4.83 x 3.74 x 9.80 mm
