YukkuriPannda/vibe_comp/kicad/bass_compressor/bass_compressor_schematic.pdf

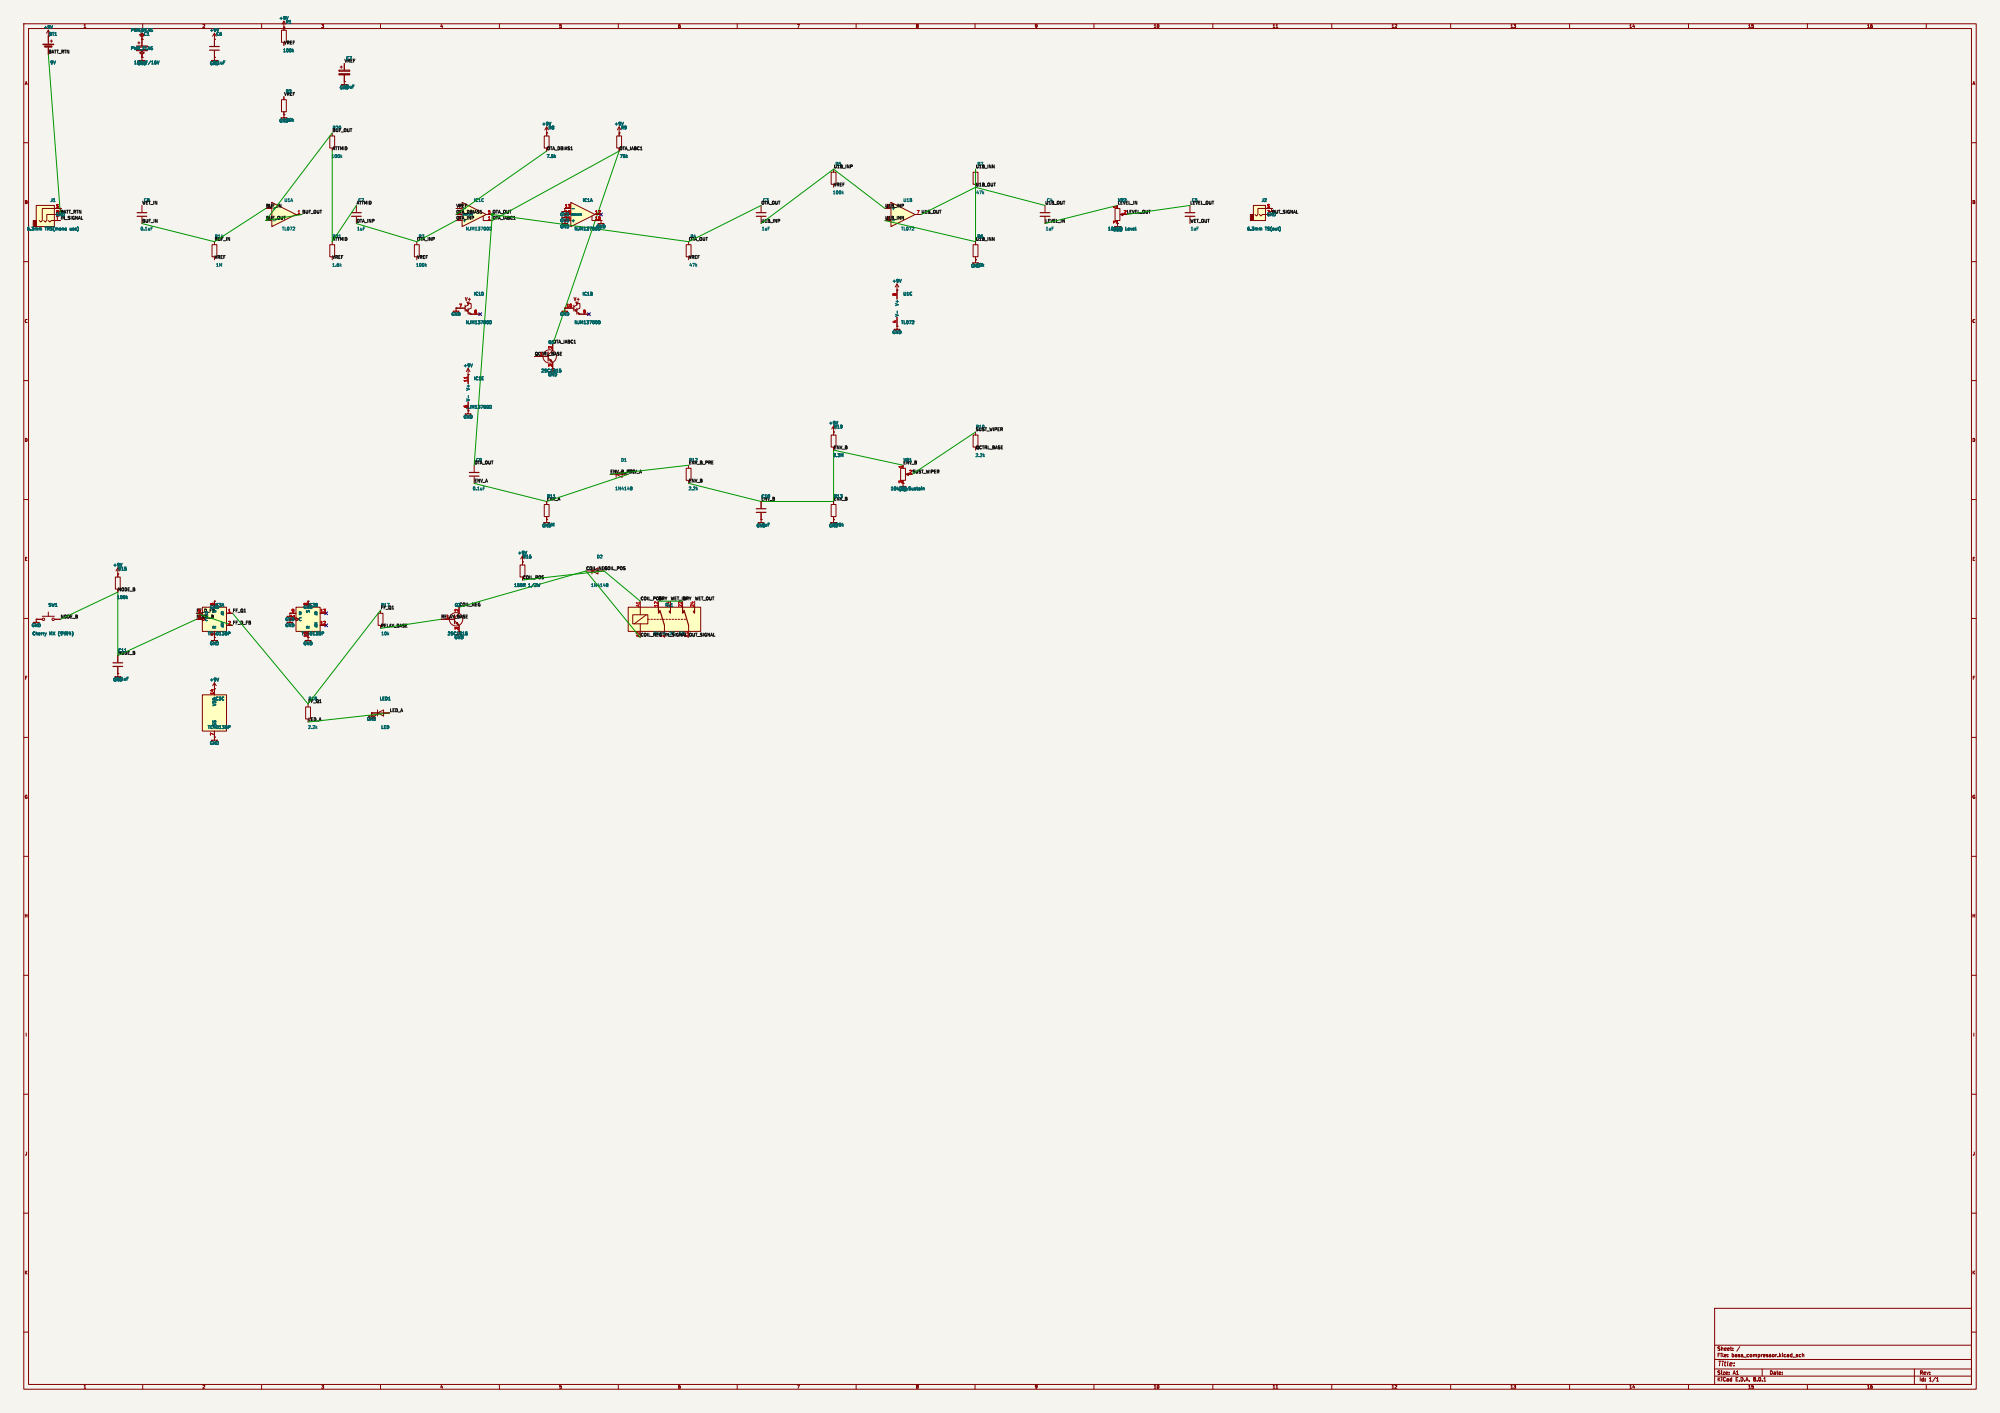
[picture p11: page 1]

SW1 Cherry MX þÿ(bKc0a) GND

Id: 1/1 Title: File: bass_compressor.kicad_sch Sheet: /
