YukkuriPannda/vibe_comp/kicad/bass_compressor/bass_compressor_preview.pdf

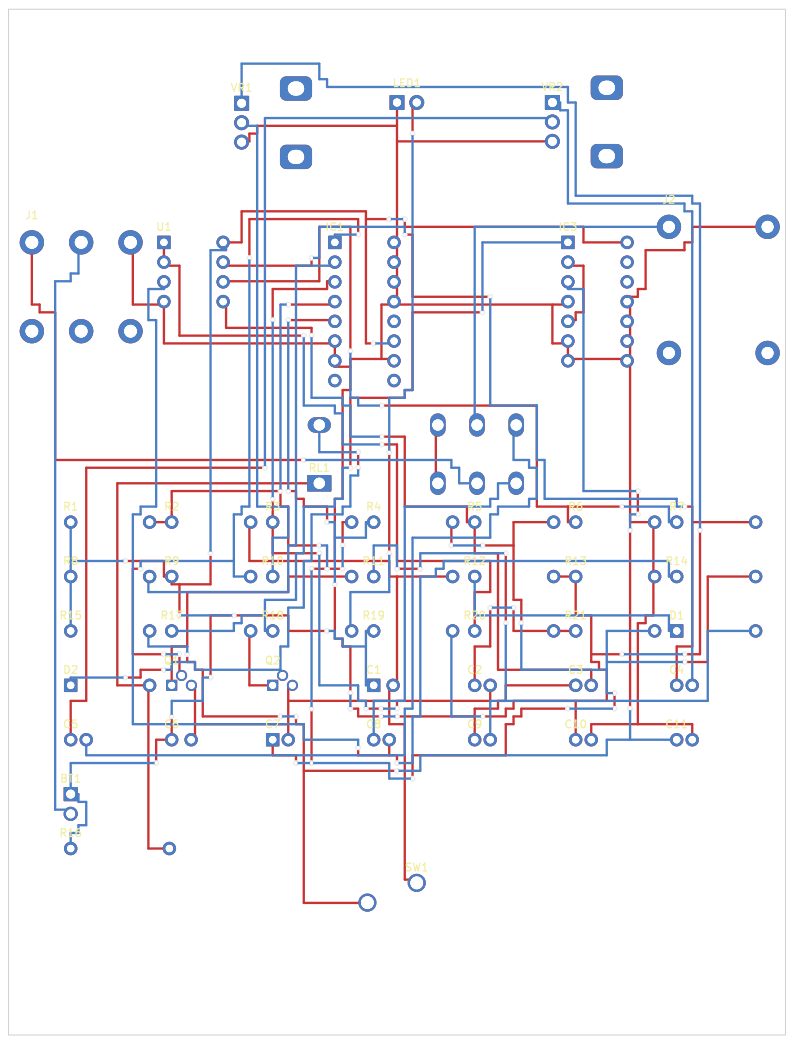
[picture p12: page 1]
