YukkuriPannda/vibe_comp/kicad/bass_compressor/bass_compressor.kicad_pcb

## KiCad design kicad/bass_compressor/bass_compressor.kicad_pcb (2026-07-01)

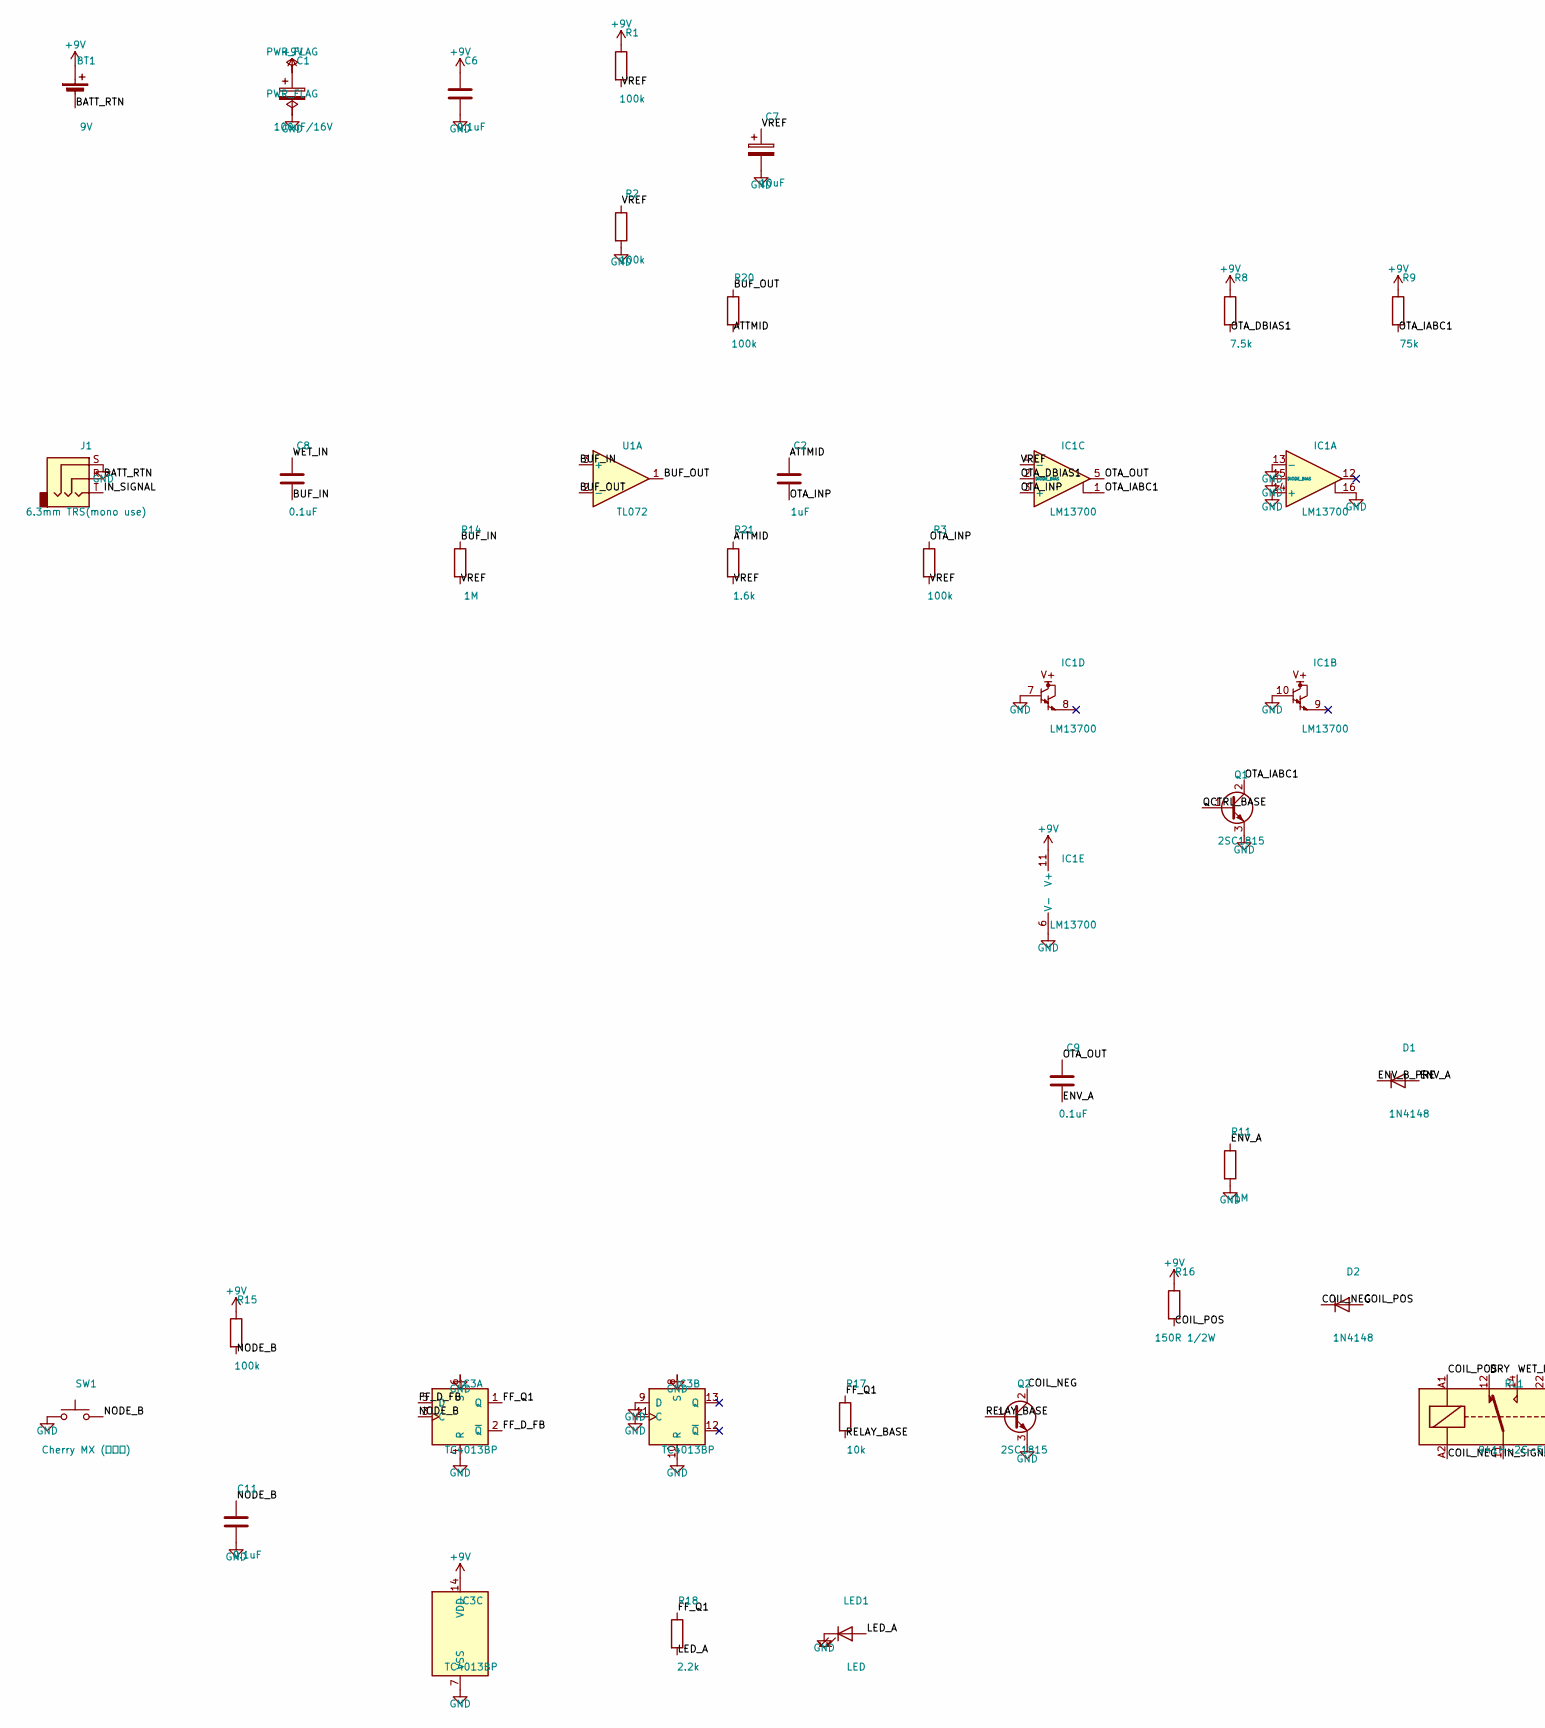
[picture p13: schematic bass_compressor.kicad_sch, part in row 1, column 1]

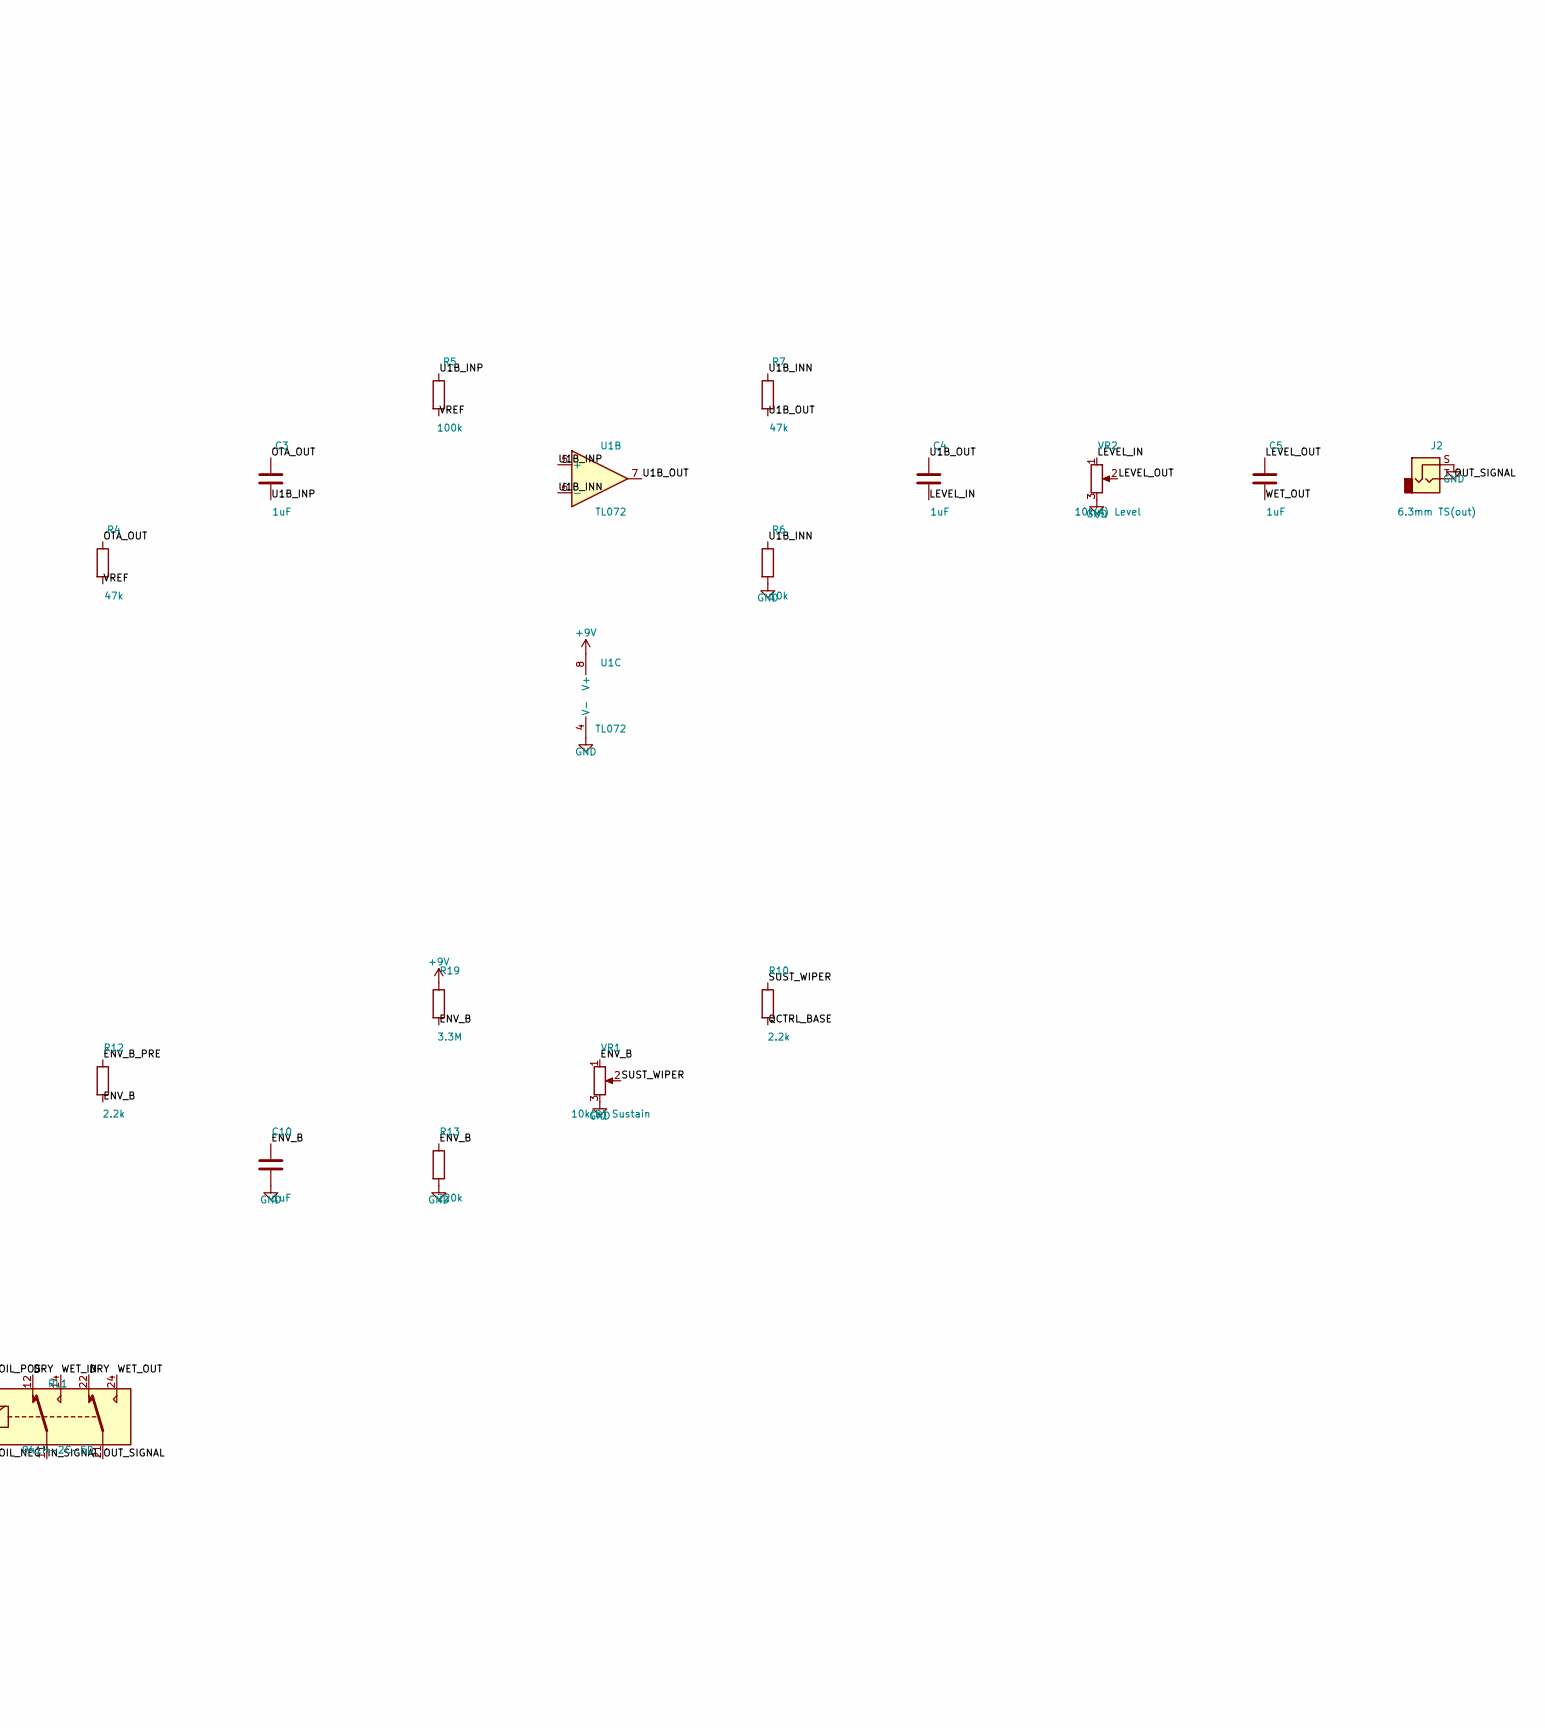
[picture p14: schematic bass_compressor.kicad_sch, part in row 1, column 2]

Parts:
BT1: 9V; PinHeader_1x02_P2.54mm_Vertical
C1: 100uF/16V; CP_Radial_D6.3mm_P2.50mm
C2, C3, C4, C5, C10: 1uF; C_Radial_D5.0mm_H11.0mm_P2.00mm
C6: 0.1uF; C_Disc_D3.0mm_W2.0mm_P2.50mm
C7: 10uF; CP_Radial_D5.0mm_P2.00mm
C8, C9, C11: 0.1uF; C_Radial_D5.0mm_H11.0mm_P2.00mm
D1, D2: 1N4148; D_DO-35_SOD27_P10.16mm_Horizontal
IC1: LM13700; DIP-16_W7.62mm_Socket
IC3: TC4013BP; DIP-14_W7.62mm_Socket
J1: 6.3mm TRS(mono use); Jack_6.35mm_Neutrik_NRJ6HF_Horizontal
J2: 6.3mm TS(out); Jack_6.35mm_Neutrik_NMJ4HCD2_Horizontal
LED1: LED; LED_D3.0mm
Q1, Q2: 2SC1815; TO-92
R1, R2, R3, R5, R15, R20: 100k; R_Axial_DIN0207_L6.3mm_D2.5mm_P10.16mm_Horizontal
R4, R7: 47k; R_Axial_DIN0207_L6.3mm_D2.5mm_P10.16mm_Horizontal
R6, R17: 10k; R_Axial_DIN0207_L6.3mm_D2.5mm_P10.16mm_Horizontal
R8: 7.5k; R_Axial_DIN0207_L6.3mm_D2.5mm_P10.16mm_Horizontal
R9: 75k; R_Axial_DIN0207_L6.3mm_D2.5mm_P10.16mm_Horizontal
R10, R12, R18: 2.2k; R_Axial_DIN0207_L6.3mm_D2.5mm_P10.16mm_Horizontal
R11, R14: 1M; R_Axial_DIN0207_L6.3mm_D2.5mm_P10.16mm_Horizontal
R13: 220k; R_Axial_DIN0207_L6.3mm_D2.5mm_P10.16mm_Horizontal
R16: 150R 1/2W; R_Axial_DIN0309_L9.0mm_D3.2mm_P12.70mm_Horizontal
R19: 3.3M; R_Axial_DIN0207_L6.3mm_D2.5mm_P10.16mm_Horizontal
R21: 1.6k; R_Axial_DIN0207_L6.3mm_D2.5mm_P10.16mm_Horizontal
RL1: 941H-2C-5D; Relay_DPDT_Schrack-RT2-FormC_RM5mm
SW1: Cherry MX (手持ち); SW_Cherry_MX_1.00u_PCB
U1: TL072; DIP-8_W7.62mm_Socket
VR1: 10k(B) Sustain; Potentiometer_Alps_RK09K_Single_Vertical
VR2: 10k(A) Level; Potentiometer_Alps_RK09K_Single_Vertical

Connections:
ATTMID: C2.1, R20.2, R21.1
BATT_RTN: BT1.2 (-), J1.R
BUF_IN: C8.2, R14.1, U1.3 (+)
BUF_OUT: R20.1, U1.1, U1.2 (-)
COIL_NEG: D2.1 (K), Q2.2 (C), RL1.A2
COIL_POS: D2.2 (A), R16.2, RL1.A1
DRY: RL1.12, RL1.22
ENV_A: C9.2, D1.2 (A), R11.1
ENV_B: C10.1, R12.2, R13.1, R19.2, VR1.1
ENV_B_PRE: D1.1 (K), R12.1
FF_D_FB: IC3.2 (~Q), IC3.5 (D)
FF_Q1: IC3.1 (Q), R17.1, R18.1
GND: C1.2, C6.2, C7.2, C10.2, C11.2, IC1.6 (V-), IC1.7, IC1.10, IC1.13 (-), IC1.14 (+), IC1.15 (DIODE_BIAS), IC1.16, IC3.4 (R), IC3.6 (S), IC3.7 (VSS), IC3.8 (S), IC3.9 (D), IC3.10 (R), IC3.11 (C), J1.S, J2.S, LED1.1 (K), Q1.3 (E), Q2.3 (E), R2.2, R6.2, R11.2, R13.2, SW1.1, U1.4 (V-), VR1.3, VR2.3
IN_SIGNAL: J1.T, RL1.11
LED_A: LED1.2 (A), R18.2
LEVEL_IN: C4.2, VR2.1
LEVEL_OUT: C5.1, VR2.2
NODE_B: C11.1, IC3.3 (C), R15.2, SW1.2
OTA_DBIAS1: IC1.2 (DIODE_BIAS), R8.2
OTA_IABC1: IC1.1, Q1.2 (C), R9.2
OTA_INP: C2.2, IC1.3 (+), R3.1
OTA_OUT: C3.1, C9.1, IC1.5, R4.1
OUT_SIGNAL: J2.T, RL1.21
QCTRL_BASE: Q1.1 (B), R10.2
RELAY_BASE: Q2.1 (B), R17.2
SUST_WIPER: R10.1, VR1.2
U1B_INN: R6.1, R7.1, U1.6 (-)
U1B_INP: C3.2, R5.1, U1.5 (+)
U1B_OUT: C4.1, R7.2, U1.7
VPLUS: BT1.1 (+), C1.1, C6.1, IC1.11 (V+), IC3.14 (VDD), R1.1, R8.1, R9.1, R15.1, R16.1, R19.1, U1.8 (V+)
VREF: C7.1, IC1.4 (-), R1.2, R2.1, R3.2, R4.2, R5.2, R14.2, R21.2
WET_IN: C8.1, RL1.14
WET_OUT: C5.2, RL1.24

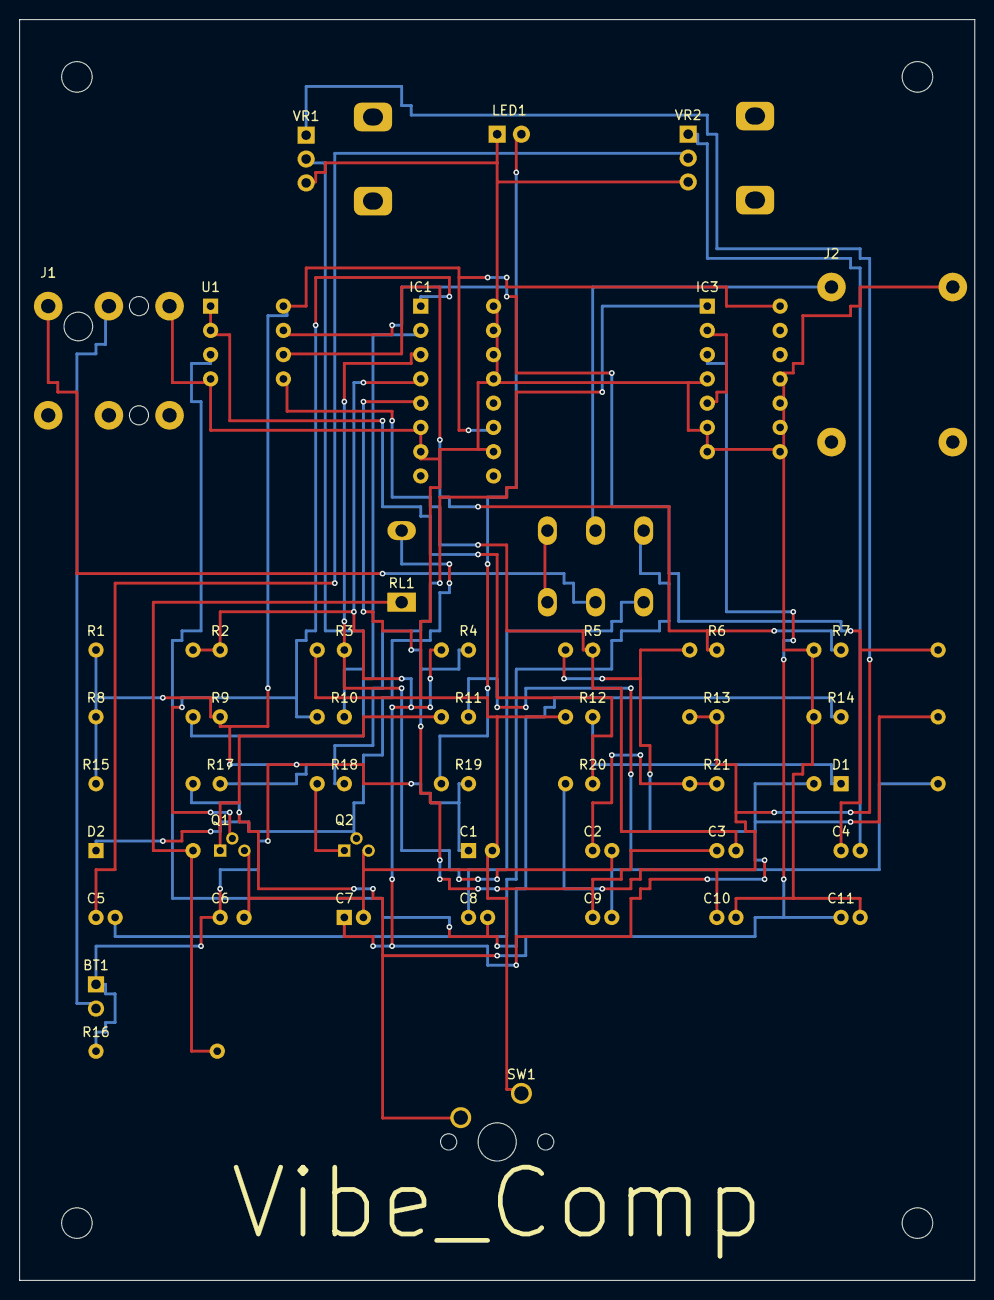
[picture p15: board bass_compressor.kicad_pcb from above]

Board: 2 copper layers, 100.0 x 132.0 mm, 51 parts (0 on the bottom side), 33 nets.

Other parts of the board:
MH1, MH2, MH3, MH4: MountingHole_3.2mm_M3
