YukkuriPannda/vibe_comp/(commit log)

2026-07-01 KiCad回路図とLTspiceシミュレーションを追加、.gitignoreでシミュレーション生成物を除外
    - LM13700/TL072/TC4013のデータシート照合済み回路をKiCad化(ERC 0エラー)
    - 手計算+LTspiceでOTA入力のアッテネータ不足・バイアス基準誤りなど計4件のバグを発見・修正
    - .raw/.npz/.log/.net等の大きい/再生成可能なシミュレーション出力は.gitignoreで除外
    [bass_compressor.kicad_sch, bom_kicad.csv]
2026-07-01 PCB基板レイアウトを詰めて100x190mm→100x132mmに縮小、操作パネル配置を変更
    均一グリッド配置だった基板を各部品の実パッド範囲に応じて詰め直し、独自A*
    グリッドルーターで全結線を再配線(DRCエラー0件・未配線0件を維持)。
    VR1/VR2を上部に並べてLEDを間に配置し、SW1を最下部に移動。3Dレンダリング
    用にCherry MXスイッチ・ロータリーポットの簡易プレースホルダーも追加。
    [bass_compressor.kicad_pcb, bass_compressor.kicad_sch, bass_compressor_render.kicad_pcb, bom_kicad.csv]
2026-07-02 PCB出力
    [ALPS-RK09K.step, BOM-bass_compressor.csv, DIP-14_W7.62mm_Socket.step, DIP-16_W7.62mm_Socket.step, DIP-8_W7.62mm_Socket.step, NEUTRIK_NMJ4HCD2.stp, NEUTRIK_NRJ6HF.stp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]
