YukkuriPannda/vibe_comp/(notices)

Notices in the files:
kicad/bass_compressor/3dmodels/DIP-16_W7.62mm_Socket.step:
Copyright (C) 2017, Terje Io
This program is free software: you can redistribute it and/or modify
it under the terms of the GNU General Public License as published by
the Free Software Foundation, either version 3 of the License, or
any later version.
itself might be covered by the GNU General Public License.
